CPasteris1/ECE-388-Design-Project-Cameron-Pasteris/README.md

# ECE-388-Design-Project-Cameron-Pasteris
Github Repository for ECE 388 Design Project
