CPasteris1/ECE-388-Design-Project-Cameron-Pasteris/renders/ECE_388_Schematic_v2.pdf

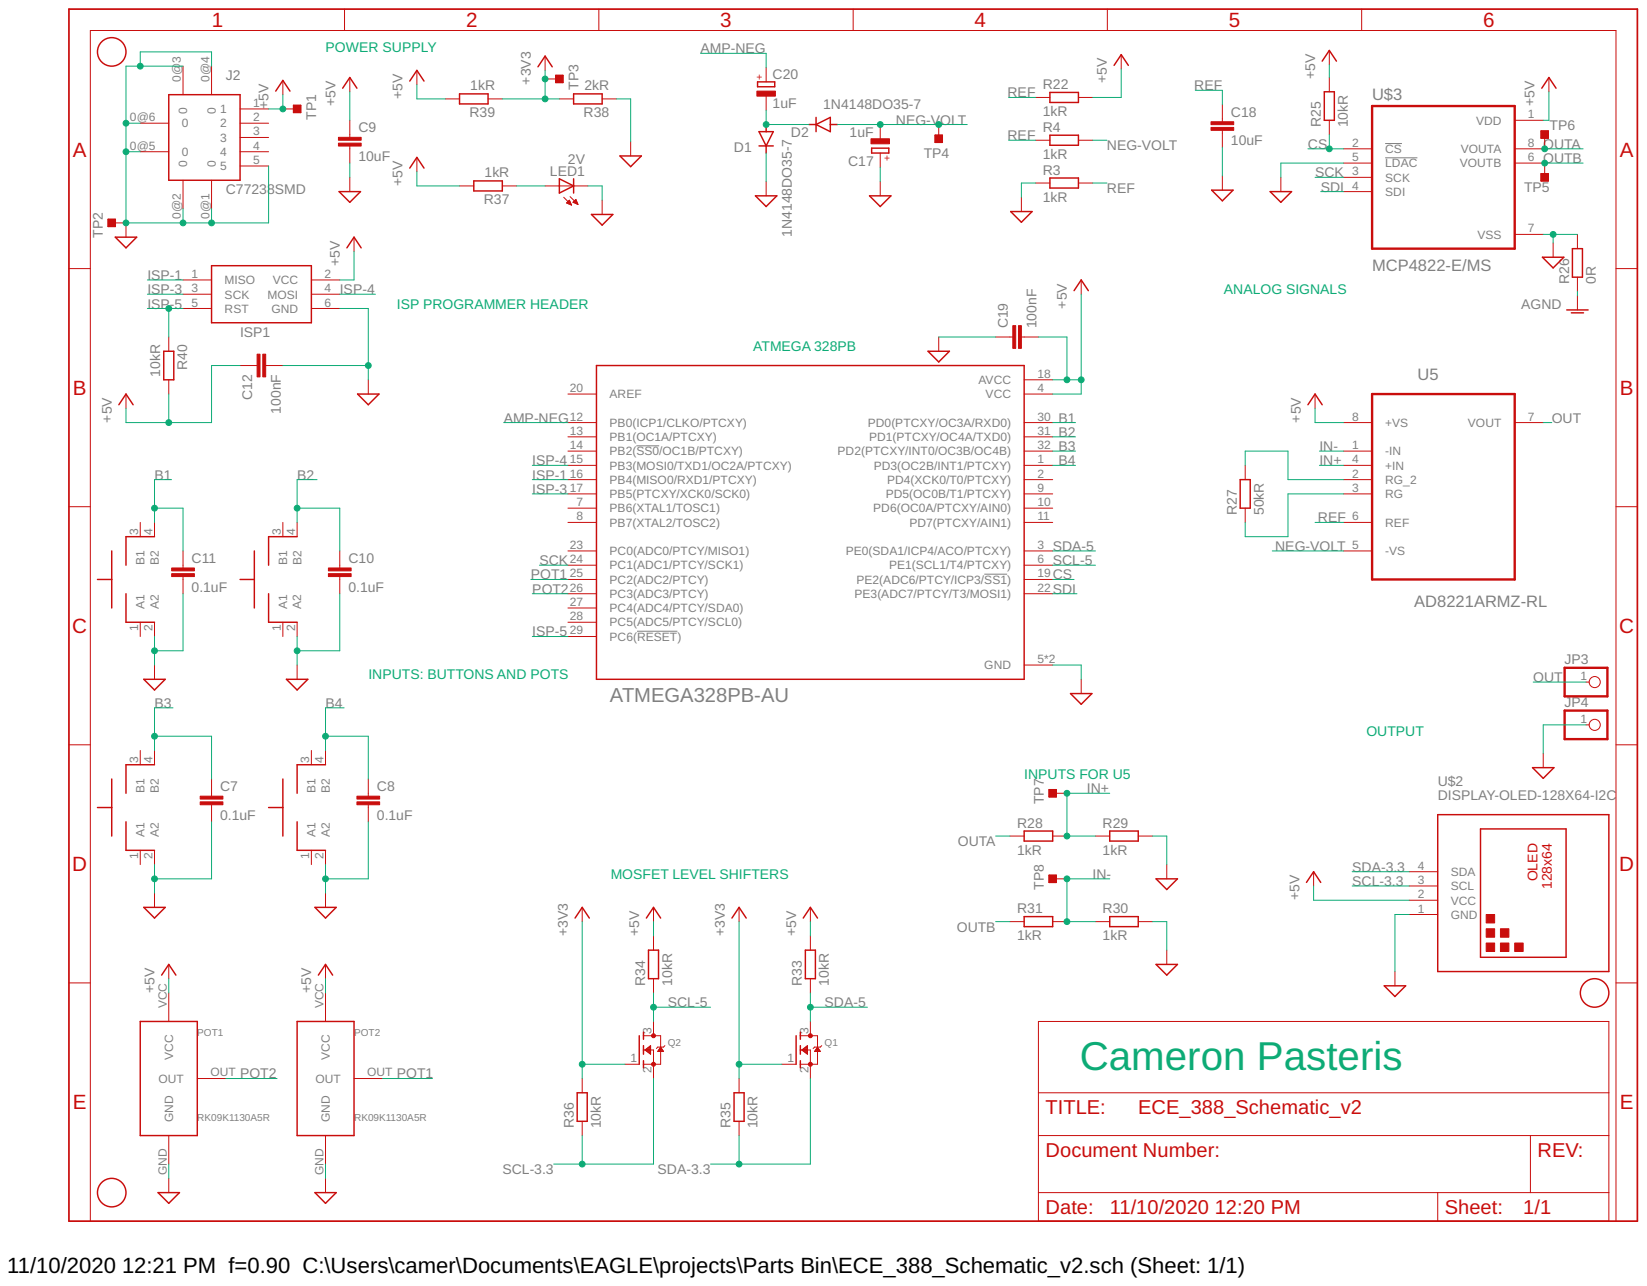
[picture p1: page 1]

REF REF

INPUTS: BUTTONS AND POTS

VCC OUT OUT GND GND

Document Number: | REV:

Date: 11/10/2020 12:20 PM | Sheet: 1/1

11/10/2020 12:21 PM f=0.90 C:\Users\camer\Documents\EAGLE\projects\Parts Bin\ECE_388_Schematic_v2.sch (Sheet: 1/1)
