CPasteris1/ECE-388-Design-Project-Cameron-Pasteris/ECE_388_Schematic_v3.brd

## EAGLE design ECE_388_Schematic_v3.brd (2020-11-19)

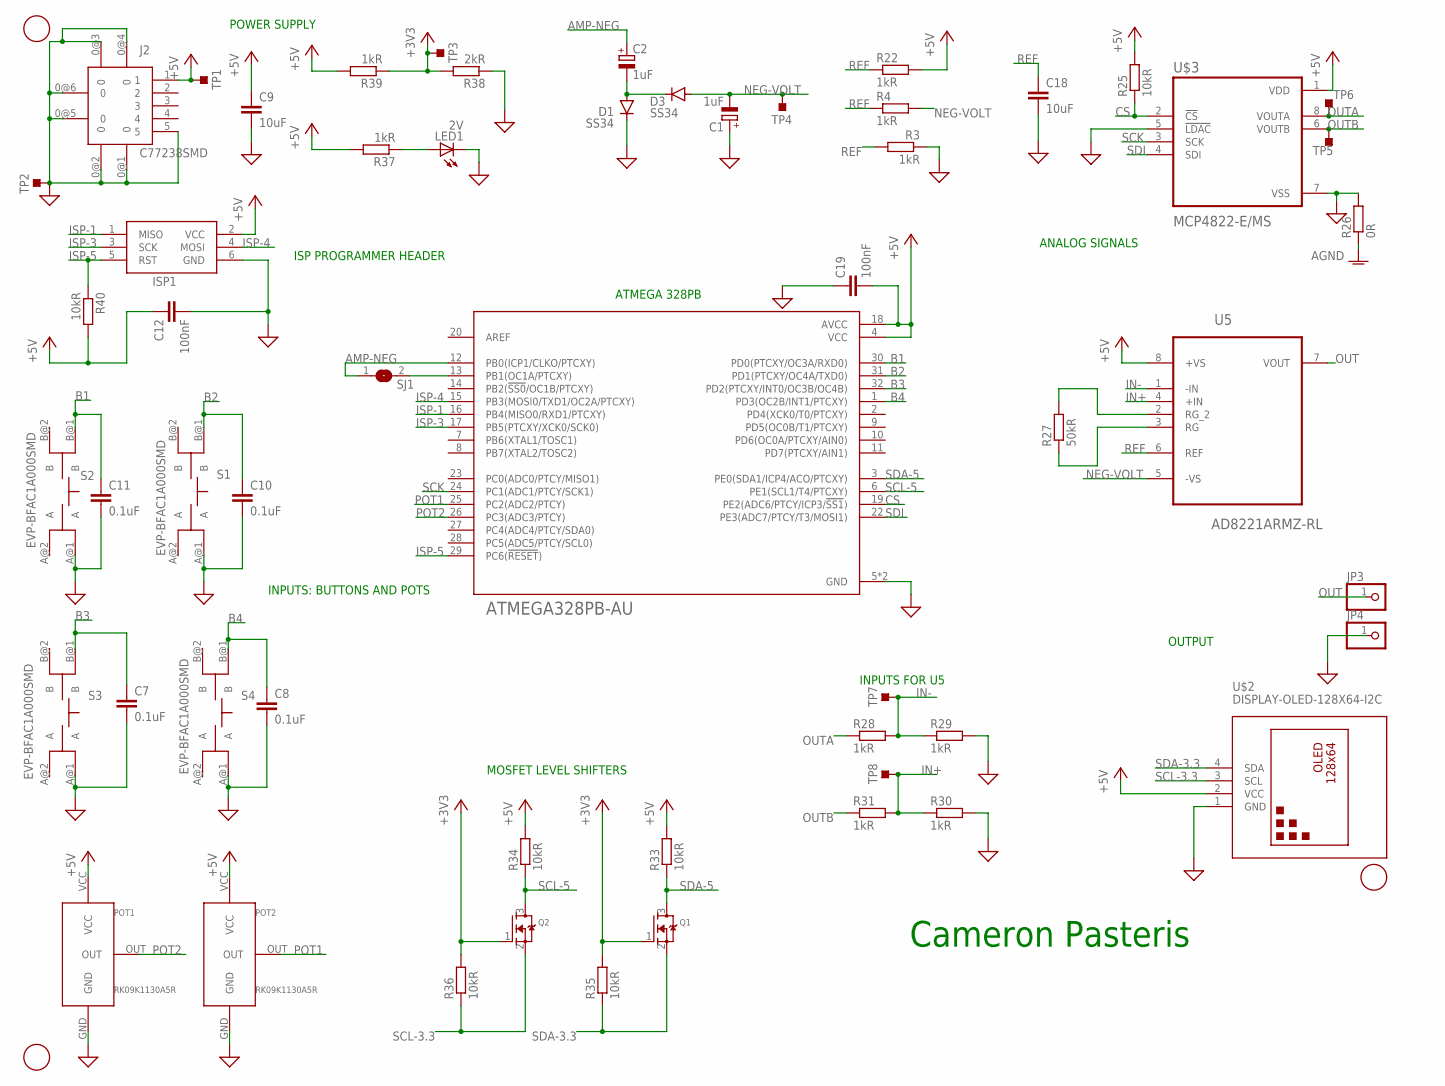
[picture p2: schematic ECE_388_Schematic_v3.sch]

Parts:
C1, C2: 1uF; E2,5-6E
C7, C8, C10, C11: 0.1uF; C0805
C9, C18: 10uF; C0805
C12, C19: 100nF; C0805
D1, D3: SS34; DO-214AC
F1, F2, F3: FIDUCIAL; FIDUCIAL_1MM
ISP1: AVRISP-6; AVRISP
J2: C77238SMD; C77238
JP3, JP4: PINHD-1X1; 1X01
LED1: 2V; CHIP-LED0805
POT1, POT2: RK09K1130A5R
Q1, Q2: MOSFET-NREFLOW; SOT23
R3, R4, R22, R28, R29, R30, R31, R37, R39: 1kR; R0805
R25, R33, R34, R35, R36, R40: 10kR; R0805
R26: 0R; R0805
R27: 50kR; R0805
R38: 2kR; R0805
S1, S2, S3, S4: EVP-BFAC1A000SMD; EVP-BFAC1A000
SJ1: SJ
TP1, TP2, TP3, TP4, TP5, TP6, TP7, TP8: TESTPOINT_TPS-PAD-036; TESTPOINT_PAD-036
U1: ATMEGA328PB-AU; QFP80P900X900X120-32N
U5: AD8221ARMZ-RL; SOP65P490X110-8N
U$2: DISPLAY-OLED-128X64-I2C
U$3: MCP4822-E/MS; SOP65P490X110-8N

Connections:
+3V3: Q1.1 (G), Q2.1 (G), R35.2, R36.2, R38.2, R39.1, TP3.1
+5V: C9.1, C12.1, C19.2, ISP1.2 (VCC), J2.1, POT1.VCC, POT2.VCC, R22.2, R25.2, R33.2, R34.2, R37.2, R39.2, R40.2, TP1.1, U1.4 (VCC), U1.18 (AVCC), U5.8 (+VS), U$2.2 (VCC), U$3.1 (VDD)
AGND: R26.1
AMP-NEG: C2.+, SJ1.1, U1.12 (PB0(ICP1/CLKO/PTCXY))
B1: C11.1, S2.B@1 (B), U1.30 (PD0(PTCXY/OC3A/RXD0))
B2: C10.1, S1.B@1 (B), U1.31 (PD1(PTCXY/OC4A/TXD0))
B3: C7.1, S3.B@1 (B), U1.32 (PD2(PTCXY/INT0/OC3B/OC4B))
B4: C8.1, S4.B@1 (B), U1.1 (PD3(OC2B/INT1/PTCXY))
CS: R25.1, U1.19 (PE2(ADC6/PTCY/ICP3/!SS1!)), U$3.2 (!CS)
GND: C1.+, C7.2, C8.2, C9.2, C10.2, C11.2, C12.2, C18.2, C19.1, D1.C, ISP1.6 (GND), J2.0@1 (0), J2.0@2 (0), J2.0@3 (0), J2.0@4 (0), J2.0@5 (0), J2.0@6 (0), J2.5, JP4.1, LED1.C, POT1.GND, POT2.GND, R3.1, R26.2, R29.2, R30.2, R38.1, S1.A@1 (A), S2.A@1 (A), S3.A@1 (A), S4.A@1 (A), TP2.1, U1.5 (GND), U1.21 (GND), U$2.1 (GND), U$3.5 (!LDAC), U$3.7 (VSS)
IN+: R30.1, R31.2, TP8.1, U5.4 (+IN)
IN-: R28.2, R29.1, TP7.1, U5.1 (-IN)
ISP-1: ISP1.1 (MISO), U1.16 (PB4(MISO0/RXD1/PTCXY))
ISP-3: ISP1.3 (SCK), U1.17 (PB5(PTCXY/XCK0/SCK0))
ISP-4: ISP1.4 (MOSI), U1.15 (PB3(MOSI0/TXD1/OC2A/PTCXY))
ISP-5: ISP1.5 (RST), R40.1, U1.29 (PC6(!RESET!))
unnamed: R27.2, U5.2 (RG_2)
unnamed: LED1.A, R37.1
unnamed: R27.1, U5.3 (RG)
unnamed: C2.-, D1.A, D3.C
unnamed: SJ1.2, U1.13 (PB1(OC1A/PTCXY))
NEG-VOLT: C1.-, D3.A, R4.2, TP4.1, U5.5 (-VS)
OUT: JP3.1, U5.7 (VOUT)
OUTA: R28.1, TP6.1, U$3.8 (VOUTA)
OUTB: R31.1, TP5.1, U$3.6 (VOUTB)
POT1: POT2.OUT, U1.25 (PC2(ADC2/PTCY))
POT2: POT1.OUT, U1.26 (PC3(ADC3/PTCY))
REF: C18.1, R3.2, R4.1, R22.1, U5.6 (REF)
SCK: U1.24 (PC1(ADC1/PTCY/SCK1)), U$3.3 (SCK)
SCL-3.3: Q2.2 (S), R36.1, U$2.3 (SCL)
SCL-5: Q2.3 (D), R34.1, U1.6 (PE1(SCL1/T4/PTCXY))
SDA-3.3: Q1.2 (S), R35.1, U$2.4 (SDA)
SDA-5: Q1.3 (D), R33.1, U1.3 (PE0(SDA1/ICP4/ACO/PTCXY))
SDI: U1.22 (PE3(ADC7/PTCY/T3/MOSI1)), U$3.4 (SDI)

Notes on the sheet:
Cameron Pasteris
POWER SUPPLY
ISP PROGRAMMER HEADER
INPUTS: BUTTONS AND POTS
MOSFET LEVEL SHIFTERS
ANALOG SIGNALS
OUTPUT
INPUTS FOR U5
ATMEGA 328PB

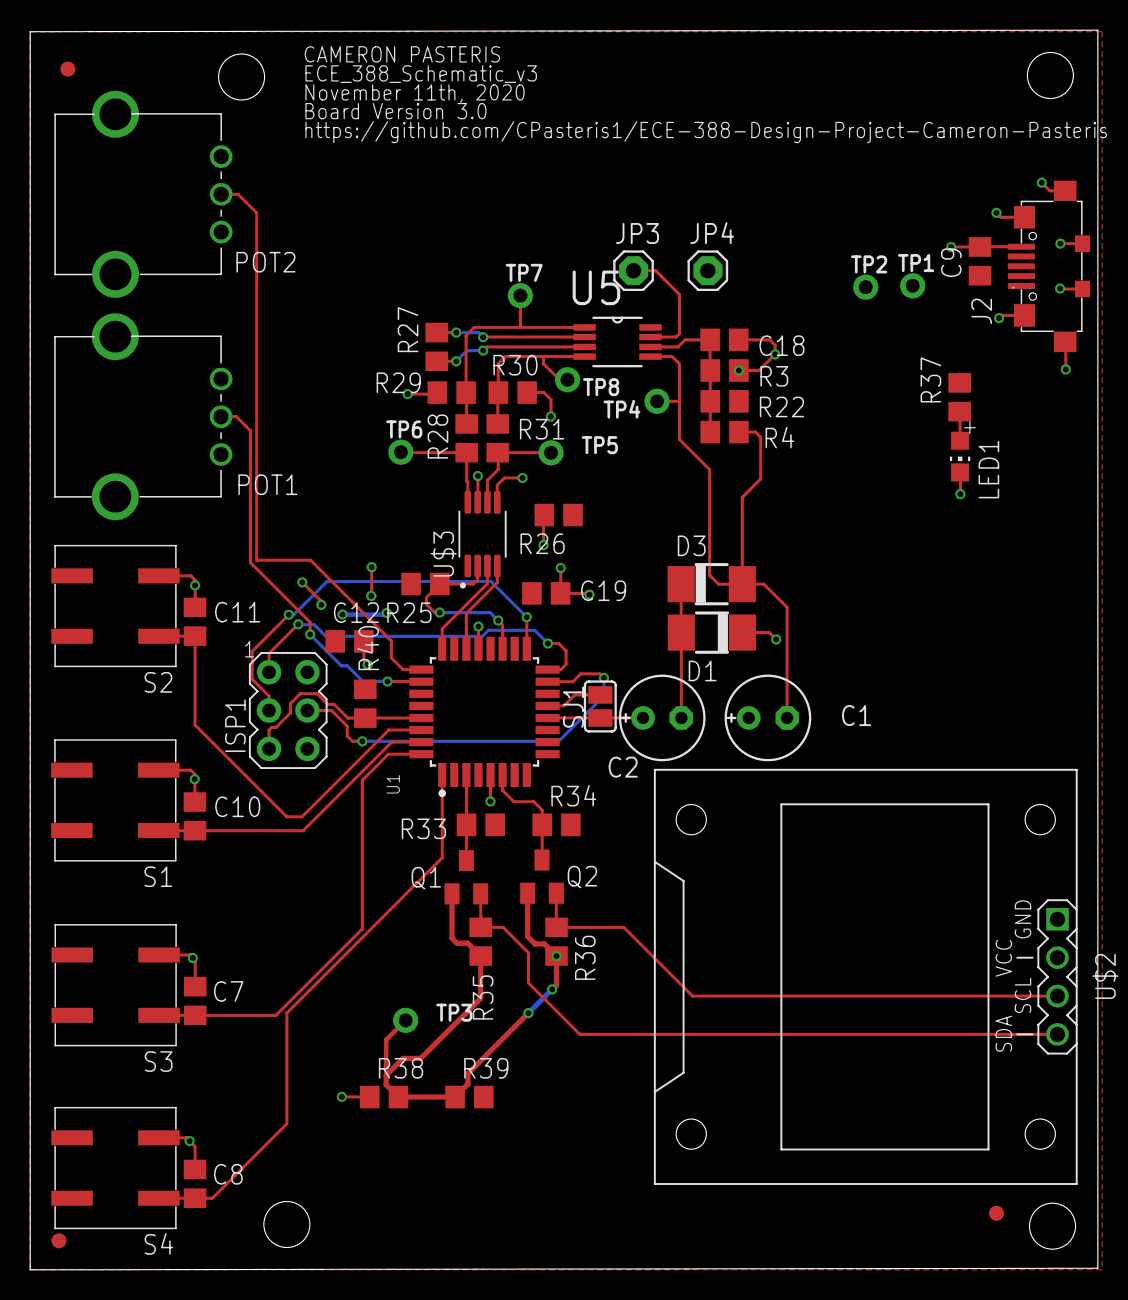
[picture p3: board ECE_388_Schematic_v3.brd from above]

Board: 2 copper layers, 70.7 x 82.1 mm, 59 parts (0 on the bottom side), 33 nets.
