CPasteris1/ECE-388-Design-Project-Cameron-Pasteris/(threads)

Thread 1 (2020-10-18):

Bom Submission

timChase98, 2020-10-18:
- [x] Price breakdowns should be unit price not extended price
- [x] Add me as an owner to the repo

Please check off the issues as you fix them. When you are done push your changes, create a new release, and close the issue with a comment that @s me. I'll review your changes and mark you as good to order parts or I'll open a new issue if you need to make changes.

CPasteris1, 2020-10-19:
@timChase98 I fixed the pricing, and added you as a collaborator

timChase98, 2020-10-19:
Looks good!

Closed 2020-10-19.

Thread 2 (2020-11-07):

Schematic Submission

timChase98, 2020-11-07:
- [x] Add me as an admin to the repo
- [x] Review the submission guidelines [HERE](https://github.com/timChase98/388Example)
- [x] All project files should be version controlled
- [x] Schematics should have clear flow from left-right
  - [x] Power input top left
  - [x] Inputs to uController middle left
  - [x] uController in the center
  - [x] uController outputs to right
- [x] Why is aref connected to gnd?
- [x] Power flags should be used over named nets for power distribution
- [x] The chip select pin for all SPI parts should have an external pull up resistor

Please address these issues and push your changes. Then create a new release, increment the tag and close this issue. I will review the changes and mark this as complete or reopen the issue with additional feedback.

CPasteris1, 2020-11-07:
I believe I have fixed these problems now, I'll make a new release for the schematic, still working on my next board layout

timChase98, 2020-11-10:
To get accepted
- [ ] What is the purpose of R11?
- [ ] Change the value of R7 to 10k
- [ ] Add test points.  Power and GND are required others are up to you
- [ ] VOUT on U5 has no connection.
- [ ] C14 and C15 are drawn as polarized capacitors in reverse bias
  - [ ] If you did not intend to use a polarized cap change to a non polarized symbol
  - [ ] If you did intend to use a polarized cap fix polarity
- [ ] Change VCC flag to match the voltage carried by the flag.  ex 5V -12V 3.3V
- [ ] Change 3.3_VCC to a 3.3V power flag

To get a PASS
- [ ] Net labels should sit on top of the net
- [ ] Label sub sections of your circuit to make logical connections clear

CPasteris1, 2020-11-10:
These should all be fixed now. I updated the release for the schematic.

timChase98, 2020-11-11:
Looks good I'll give this a pass

Closed 2020-11-10.

Thread 3 (2020-11-08):

Board Submission

timChase98, 2020-11-08:
- [x] Review the submission guidelines [HERE](https://github.com/timChase98/388Example)
- [x] All project files should be version controlled
- [x] Boards will not be graded unless both Eagle files and correctly generated Gerber files are present
- [x] All traces should hit the center of pads
- [x] Power traces should have a minimum width of 12 mil or run through a plane
- [x] Silkscreen labels must include
  - [x] Your Name
  - [x] Project Name
  - [x] Date
  - [x] Version/Rev
  - [x] Github Link
- [x] Check stock sheet for correct footprints for
  - [x] USB connector
  - [x] Pots
  - [x] Diodes
  - [x] Caps
  - [x] Buttons
  - [x] OLED
- [x] Your project would fit on a much smaller board
- [x] Placement of fiducials should be
  - [x] FID1 lower left
  - [x] FID2 upper left
  - [x] FID3 lower right
- [x] Silkscreen cant overlap outside of board

These are initial comments meant to guide you through the layout process.  I will not look at your board again until your schematic passes review.  This is to reduce the workload on you by limiting the number of times you need to relayout your board due to schematic errors.

Please address these issues and push your changes. Then create a new release, increment the tag and close this issue. I will review the changes and mark this as complete or reopen the issue with additional feedback.

CPasteris1, 2020-11-11:
I updated as many footprints as I could, most of them I made by following the datasheets' layouts. The OLED I did not update, because there was no datasheet for the display on the website, and from the information I could find it has the same dimensions as the footprint that is on my board. It is not a smaller board, I tried to condense it, but I also had to fit the silkscreen info.

timChase98, 2020-11-11:
You have silkscreen off the edge of your board.  Fix this and I'll accept your layout.

CPasteris1, 2020-11-12:
Should be all set now, I think I moved all labels and silkscreen to make sure it wasn't over the edge.

timChase98, 2020-11-12:
I'll accept this.

timChase98, 2020-11-16:
Your board was sent to fab

Closed 2020-11-12.
